Bingo2023/diyBMSv4/ModuleV450_Bolt123_revB/render_top.png

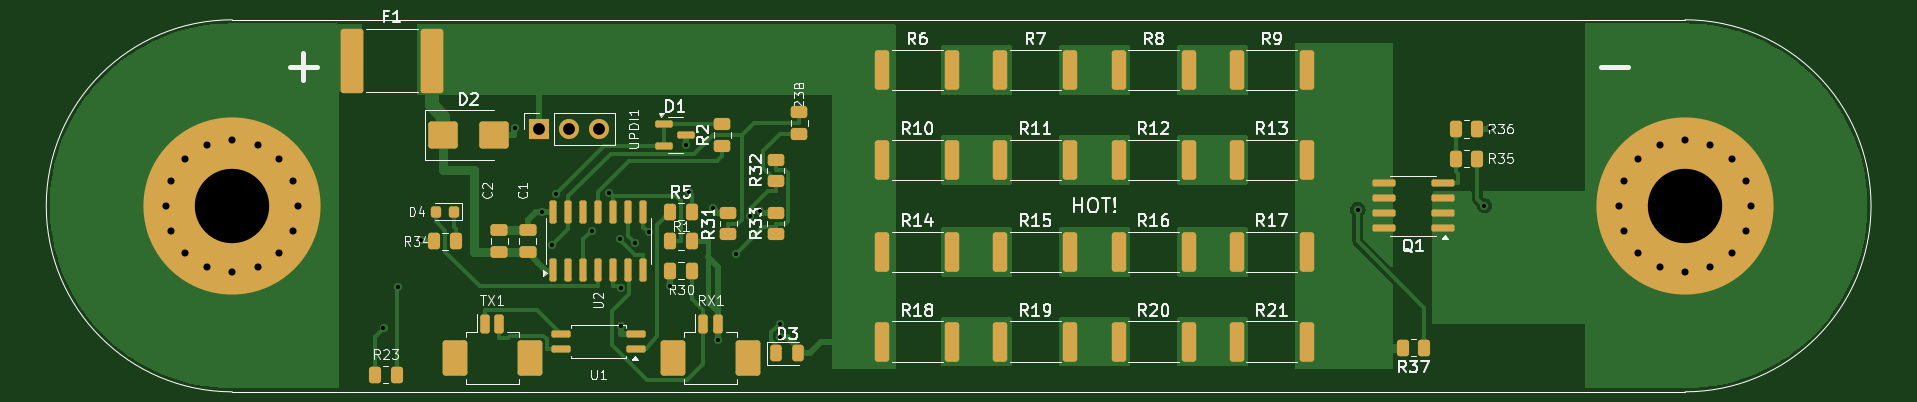
ModuleV450_Bolt123_revB/render_top.png
