Bingo2023/diyBMSv4/ModuleV450_Bolt123_V1/images/ModuleV450_Bolt123_V1_foto_bestueckt.jpg

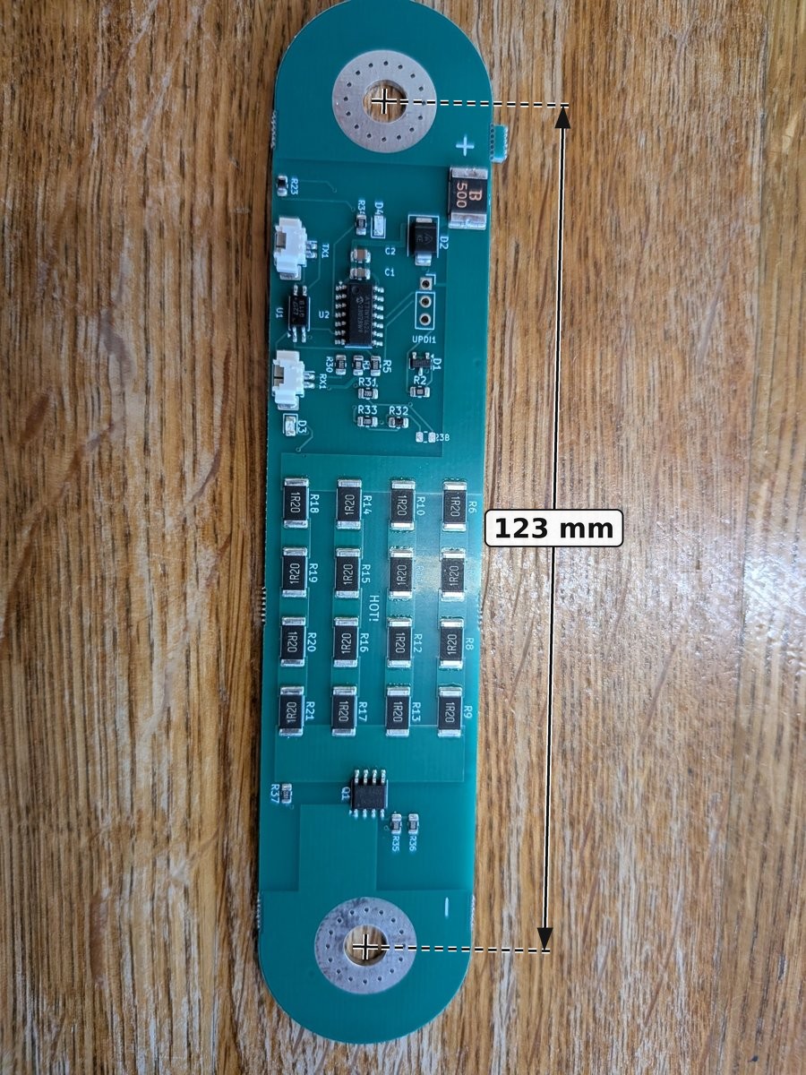
ModuleV450_Bolt123_V1/images/ModuleV450_Bolt123_V1_foto_bestueckt.jpg
