Bingo2023/diyBMSv4/ModuleV450_Bolt89/ModuleV450_Bolt89_Schaltplan.pdf

## 1 Zellanschluss, Sicherung, MCU-Versorgung (Sternpunkt an F1)

## 2 Mikrocontroller ATtiny1624-SSU (U2)

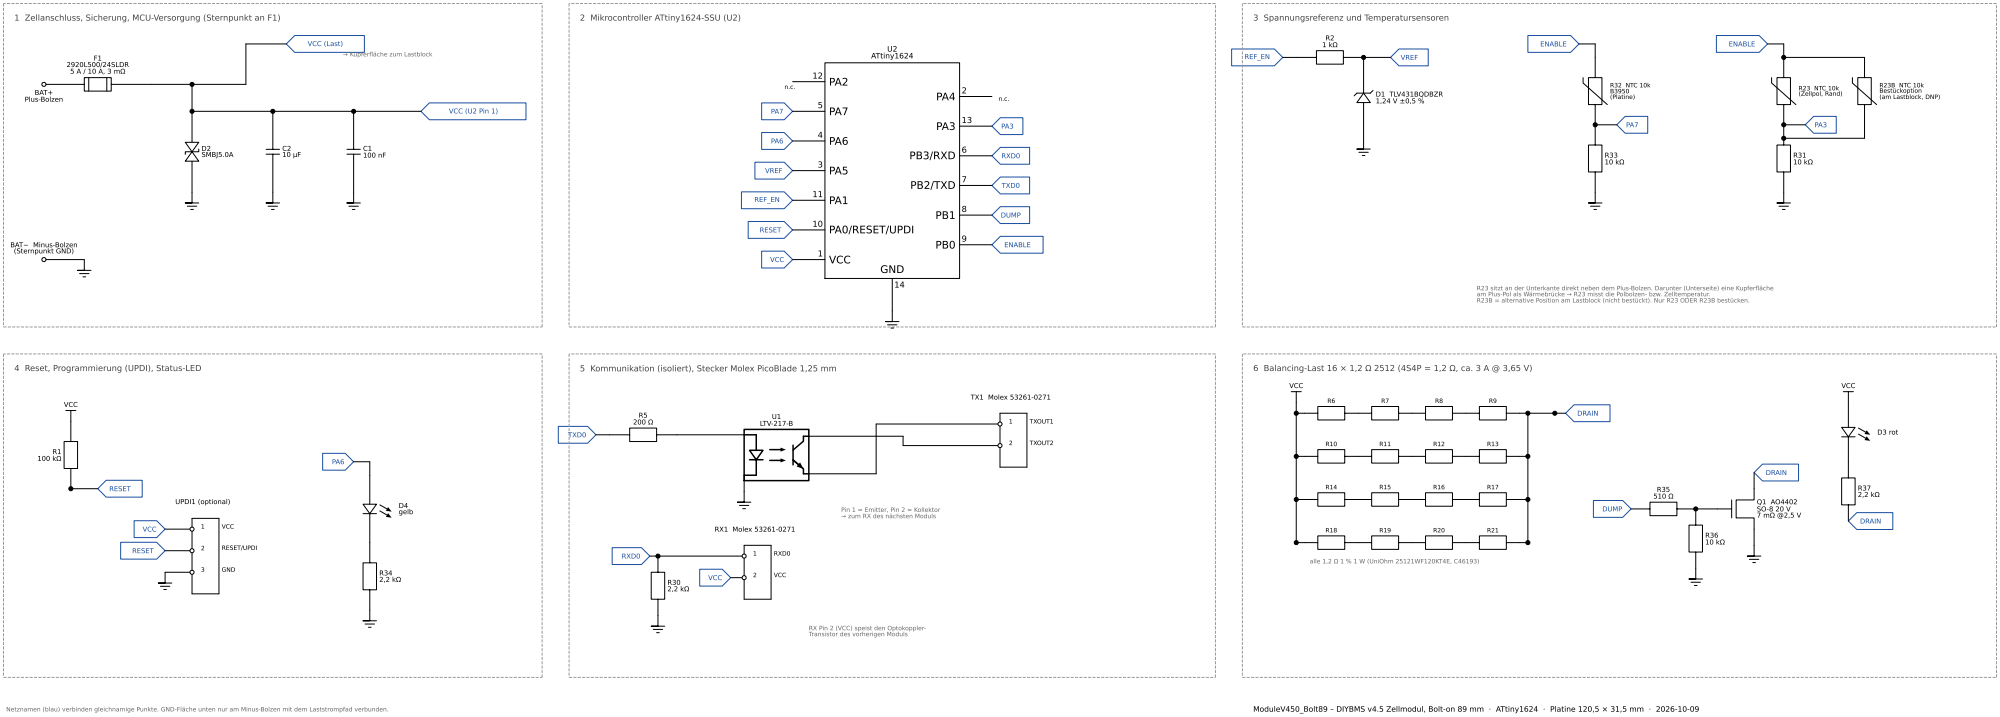
[picture p7: page 1]

R23 sitzt an der Unterkante direkt neben dem Plus-Bolzen. Darunter (Unterseite) eine Kupferfläche
am Plus-Pol als Wärmebrücke → R23 misst die Polbolzen- bzw. Zelltemperatur.
R23B = alternative Position am Lastblock (nicht bestückt). Nur R23 ODER R23B bestücken.

4 Reset, Programmierung (UPDI), Status-LED

5 Kommunikation (isoliert), Stecker Molex PicoBlade 1,25 mm

Pin 1 = Emitter, Pin 2 = Kollektor
→ zum RX des nächsten Moduls

RX Pin 2 (VCC) speist den Optokoppler-
Transistor des vorherigen Moduls
