Bingo2023/diyBMSv4/ModuleV450_Bolt123_V1/ModuleV450_Bolt123_V1.kicad_pcb

## KiCad design ModuleV450_Bolt123_V1/ModuleV450_Bolt123_V1.kicad_pcb (2026-10-08)

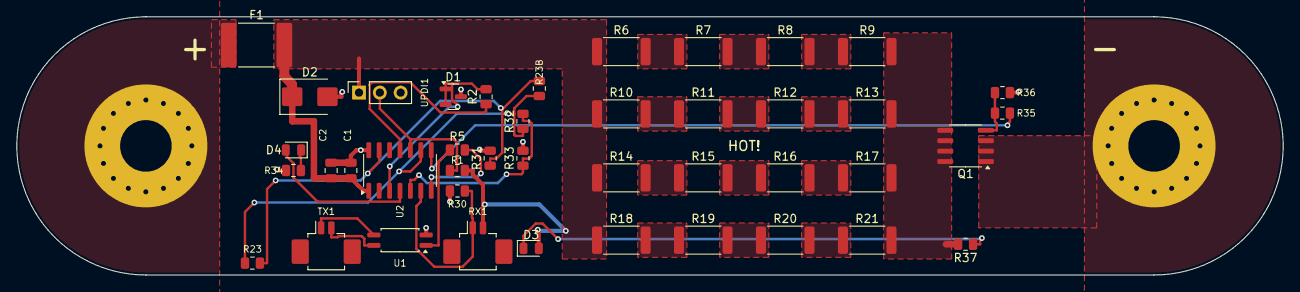
[picture p8: board ModuleV450_Bolt123_V1.kicad_pcb from above]

Board: 2 copper layers, 154.5 x 31.5 mm, 45 parts (1 on the bottom side), 32 nets.

Parts:
BAT+: M6 bolt 6.3mm
BAT-: M6 bolt 6.3mm
C1: 100nF; C_0805_2012Metric
C2: 10uF; C_0805_2012Metric
D1: TLV431BQDBZR; SOT-23
D2: SMBJ5.0A; D_SMB
D3: Red; LED_0805_2012Metric
D4: Yellow; LED_0805_2012Metric
F1: 2920L500 5A; Fuse_2920_7451Metric
G1: LOGO; diybms_logo_24x10mm
Q1: AO4402; SOIC-8_3.9x4.9mm_P1.27mm
R1: 100K; R_0805_2012Metric
R2: 1K; R_0805_2012Metric
R5: 180R; R_0805_2012Metric
R6, R7, R8, R9, R10, R11, R12, R13, R14, R15, R16, R17, R18, R19, R20, R21: 1R2; R_2512_6332Metric
R23, R32: NTC 10K B3950; R_0805_2012Metric
R23B: NTC 10K B3950 DNP; R_0805_2012Metric
R30, R34, R37: 2K2; R_0805_2012Metric
R31, R33, R36: 10K; R_0805_2012Metric
R35: 510R; R_0805_2012Metric
RX1: RX; Molex_PicoBlade_53261-0271_1x02-1MP_P1.25mm_Horizontal
TX1: TX; Molex_PicoBlade_53261-0271_1x02-1MP_P1.25mm_Horizontal
U1: EL3H7(B)(TA)-G; SOP-4_4.4x2.6mm_P1.27mm
U2: ATTINY1624-SSU; SOIC-14_3.9x8.7mm_P1.27mm
UPDI1: UPDI; PinSocket_1x03_P2.54mm_Vertical

Connections:
BAT+: BAT+.1, F1.1
DRAIN: Q1.5, Q1.6, Q1.7, Q1.8, R9.2, R13.2, R17.2, R21.2, R37.2
DUMP: R35.1, U2.8
ENABLE: R23.1, R23B.1, R32.1, U2.9
GATE: Q1.4, R35.2, R36.2
GND: BAT-.1, C1.2, C2.2, D1.3, D2.2, Q1.1, Q1.2, Q1.3, R30.1, R31.2, R33.2, R34.1, R36.1, U1.2, U2.14, UPDI1.3
LED_B: D4.1, R34.2
LED_R: D3.1, R37.1
OPTO_A: R5.1, U1.1
PA3: R23.2, R23B.2, R31.1, U2.13
PA6: D4.2, U2.4
PA7: R32.2, R33.1, U2.5
REF_EN: R2.1, U2.11
RESET: R1.2, U2.10, UPDI1.2
RXD0: R30.2, RX1.1, U2.6
S1_1: R6.2, R7.1
S1_2: R7.2, R8.1
S1_3: R8.2, R9.1
S2_1: R10.2, R11.1
S2_2: R11.2, R12.1
S2_3: R12.2, R13.1
S3_1: R14.2, R15.1
S3_2: R15.2, R16.1
S3_3: R16.2, R17.1
S4_1: R18.2, R19.1
S4_2: R19.2, R20.1
S4_3: R20.2, R21.1
TXD0: R5.2, U2.7
TXOUT1: TX1.1, U1.3
TXOUT2: TX1.2, U1.4
VCC: C1.1, C2.1, D2.1, D3.2, F1.2, R1.1, R6.1, R10.1, R14.1, R18.1, RX1.2, U2.1, UPDI1.1
VREF: D1.1, D1.2, R2.2, U2.3
