Bingo2023/diyBMSv4/(commit log)

2026-10-08 ModuleV450 Bolt123 Rev B: Zellmodul im Format der BMS_alt (123 mm Lochabstand)
    KiCad-Layout, Schaltplan, Gerber/BOM/CPL fuer JLCPCB, Generator-Skripte.
    16 x 1R2 2512 Last (1,2 Ohm gesamt), AO4402, PTC 5 A, PicoBlade RX/TX.
    Hinweis auf das Firmware-Update ueber die RX/TX-Kette (diyBMSv4ESP32).
    Claude-Session: https://claude.ai/code/session_01F9Sf3Qw6VpdottHgQQZVxY
    [ModuleV450_Bolt123_revB.kicad_pcb, ModuleV450_Bolt123_revB_bom_full.csv, ModuleV450_Bolt123_revB_bom_jlc.csv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]
2026-10-08 Gerber-Paket fuer JLCPCB ergaenzen (*.zip ist sonst ignoriert)
    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
2026-10-08 Add ModuleV450_Bolt123_V1 (bolt-on cell module, 123 mm hole spacing)
    DIYBMS v4.5 cell module (ATtiny1624) redesigned in the BMS_alt form factor:
    - 123 mm bolt spacing, 6.3 mm plated holes
    - 16x 1.2 ohm 2512 load (1.2 ohm total, ~3 A at 3.65 V), AO4402 MOSFET
    - EMV layout: quiet MCU zone, copper-pour power paths, star supply
    - Molex PicoBlade 1.25 mm comms connectors
    - JLCPCB Gerber, BOM and CPL, schematic, KiCad 7 board and generator scripts
    Claude-Session: https://claude.ai/code/session_01SqYaZD5MyB12zL6XbmoSpE
    [ModuleV450_Bolt123_V1-B_Cu.gbl, ModuleV450_Bolt123_V1-B_Mask.gbs, ModuleV450_Bolt123_V1-B_Silkscreen.gbo, ModuleV450_Bolt123_V1-Edge_Cuts.gm1, ModuleV450_Bolt123_V1-F_Cu.gtl, ModuleV450_Bolt123_V1-F_Mask.gts, ModuleV450_Bolt123_V1-F_Paste.gtp, ModuleV450_Bolt123_V1-F_Silkscreen.gto]
2026-10-27 ModuleV450_Bolt123_V1 update + new ModuleV450_Bolt89, preview images, JLC order data
    ModuleV450_Bolt123_V1:
    - JLC CPL fixes verified in the JLC assembly preview: D2 (SMB) polarity,
    U1 (LTV-217) +180 deg, PicoBlade TX1/RX1 placed by pad centre
    - D1 -> TI TLV431BQDBZR, D4 yellow 0805
    - 4-up customer panel (panel4/): Gerber, BOM, CPL, mouse bites, rails, fiducials
    - rendered top/bottom/panel previews and photo of the assembled board
    ModuleV450_Bolt89 (new): 89 mm bolt spacing, rounded ends, compact MCU zone,
    Q1 between load block and Minus bolt; single board + 4-up panel with all JLC order files
    Claude-Session: https://claude.ai/code/s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
2026-10-27 Preview images: dimension the bolt spacing (123 mm / 89 mm)
    Dimension line with centre marks, extension lines and arrows on the top/bottom
    renders of both boards and on the photo of the assembled Bolt123_V1.
    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
2026-10-27 Preview images: dimension label as plain number ("89 mm" / "123 mm")
    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
2026-10-27 English docs: READMEs, schematics, photo
    - READMEs of ModuleV450_Bolt123_V1 and ModuleV450_Bolt89 translated to English
    - schematics regenerated with English labels (also F1 = 2920L500/30GR, 5 mOhm)
    and renamed *_Schaltplan.* -> *_schematic.*
    - photo of the assembled board rotated to landscape, cropped, dimensioned (123 mm),
    renamed to *_photo_assembled.jpg
    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
2026-10-27 Remove one-off helper scripts gndfix.py and swapd4.py
    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
